jmiller3931/PNI_COIN/PNICoin.xlsx

Designator | MPN | Qty | LINK | Value
C1,C10, C11 | CC0402MRX5R5BB475 | 3 |  | 4.7u
C12 | CL05A106MP8NUB8 | 1 |  | 10u 10V
C14 | CC0402KRX7R9BB103 | 1 |  | 10000p
C2, C3, C4, C6, C13, C15, C16, C17, C18 | CC0402KRX5R6BB104 | 9 |  | 100nF 10V
C5, C9 | CC0402JRNPO9BN101 | 2 |  | 100p
C7, C8, C19 | CC0402KRX5R6BB105 | 3 |  | 1u
J1 | 781710002 | 1 | https://www.digikey.com/product-detail/en/molex/0781710002/WM4459CT-ND/2424928 | CONN_HDR_PICO_EZMATE_2P
J2 | ZX62-AB-5PA(31) | 1 |  | CONN_MICROUSB_HIROSE_XZ024_SMD
LED1, LED2, LED3 | QBLP595-R | 3 | https://www.digikey.com/product-detail/en/qt-brightek-qtb/QBLP595-R/1516-1217-1-ND/6201914 | LEDRED
M1 | SPBTLE-RFTR | 1 |  | MODULE_SPBTLE
R1, R10 | RC0402JR-070RL | 2 |  | 0R
R12 | RC0402FR-07470RL | 1 |  | 470R
R13 | RC0402FR-076K8L | 1 |  | 6.8k
R15 | RC0402FR-0733K2L | 1 |  | 33.2k 1%
R2, R16, R17, R18, R19, R20 | RC0402FR-07121RL | 6 |  | 121R 1%
R3, R4, R5 | RC0402FR-0710KL | 3 |  | 10k
R6, R7 | RC0402FR-074K7L | 2 |  | 4.7k
R8, R9 | RC0402FR-07560RL | 2 |  | 560R
SW1, SW2 | B3U-3000P-B | 2 |  | SW_PB
U1 | STM32L451CEU6 | 1 |  | STM32L451CEU6UFQFPN48
U2 | TPS76433DBVR | 1 |  | TPS76433DBVR
U3 | MCP73832T-2ACI/OT | 1 |  | IC_MCP73832
U4 | Customer Supplied | 1 |  | Note: PNI Will provide U4, MPN: ASM330LHH
U5 | Customer Supplied | 1 | https://www.pnicorp.com/product/rm3100-3 | Note: PNI Will provide U5,SEN1-3: Contact Joe Miller, jmiller@pnicorp.com
SEN-1,SEN2 | Customer Supplied | 2 | https://www.pnicorp.com/product/rm3100-3 | Note: PNI Will provide U5,SEN1-3: Contact Joe Miller, jmiller@pnicorp.com
SEN3 | Customer Supplied | 1 | https://www.pnicorp.com/product/rm3100-3 | Note: PNI Will provide U5,SEN1-3: Contact Joe Miller, jmiller@pnicorp.com
