jmiller3931/PNI_COIN/PNICoin.brd

## EAGLE design PNICoin.brd (2019-02-15)

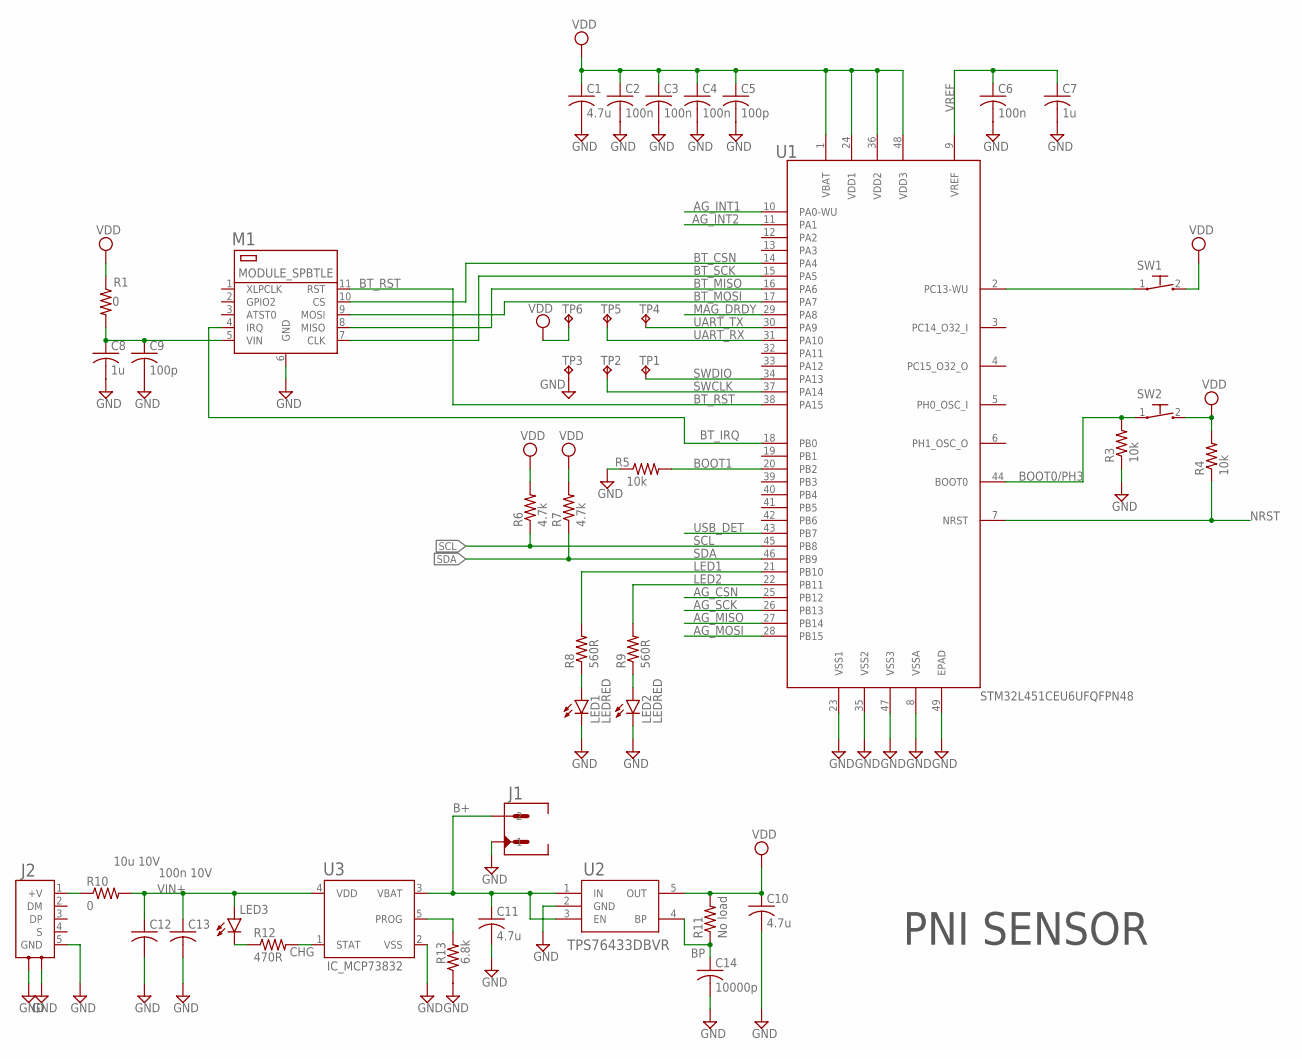
[picture p1: schematic PNICoin.sch, sheet 1]

Parts:
C1, C10, C11: 4.7u; C0402K
C2, C3, C4, C6: 100n; C0402K
C5, C9: 100p; C0402K
C7, C8: 1u; C0402K
C12: 10u 10V; C0402K
C13: 100n 10V; C0402K
C14: 10000p; C0402K
J1: CONN_HDR_PICO_EZMATE_2P; CON_HDR_PICO-EZMATE_2P
J2: CONN_MICROUSB_HIROSE_XZ024_SMD; CON_MICROUSB_HIROSE_XZ024_SMD
LED1, LED2, LED3: LEDRED; LED_0402
M1: MODULE_SPBTLE
R1, R10: 0; R0402
R3, R4, R5: 10k; R0402
R6, R7: 4.7k; R0402
R8, R9: 560R; R0402
R11: No load; R0402
R12: 470R; R0402
R13: 6.8k; R0402
SW1, SW2: SW_PB; SW-PB_B3U-3000PB
TP1, TP2, TP3, TP4, TP5, TP6: TPTP06R; TP06R
U1: STM32L451CEU6UFQFPN48; QFN50P700X700X60-49T560
U2: TPS76433DBVR; DBV5
U3: IC_MCP73832; SOT95P240X125-5

Connections:
AG_CSN: U1.25 (PB12); also elsewhere on the board
AG_INT1: U1.10 (PA0-WU); also elsewhere on the board
AG_INT2: U1.11 (PA1); also elsewhere on the board
AG_MISO: U1.27 (PB14); also elsewhere on the board
AG_MOSI: U1.28 (PB15); also elsewhere on the board
AG_SCK: U1.26 (PB13); also elsewhere on the board
B+: C11.1, J1.2, U2.1 (IN), U2.3 (EN), U3.3 (VBAT)
BLEV+: C8.1, C9.1, M1.5 (VIN), R1.2
BOOT0/PH3: R3.2, SW2.1, U1.44 (BOOT0)
BOOT1: R5.2, U1.20 (PB2)
BP: C14.1, R11.1, U2.4 (BP)
BT_CSN: M1.10 (CS), U1.14 (PA4)
BT_IRQ: M1.4 (IRQ), U1.18 (PB0)
BT_MISO: M1.8 (MISO), U1.16 (PA6)
BT_MOSI: M1.9 (MOSI), U1.17 (PA7)
BT_RST: M1.11 (RST), U1.38 (PA15)
BT_SCK: M1.7 (CLK), U1.15 (PA5)
CHG: R12.2, U3.1 (STAT)
GND: C1.2, C2.2, C3.2, C4.2, C5.2, C6.2, C7.2, C8.2, C9.2, C10.2, C11.2, C12.2, C13.2, C14.2, J1.1, J2.5 (GND), J2.6 (SH1), J2.7 (SH2), LED1.K (C), LED2.K (C), M1.6 (GND), R3.1, R5.1, R13.1, TP3.TP, U1.8 (VSSA), U1.23 (VSS1), U1.35 (VSS2), U1.47 (VSS3), U1.49 (EPAD), U2.2 (GND), U3.2 (VSS); also elsewhere on the board
LED1: R8.2, U1.21 (PB10)
LED1A: LED1.A, R8.1
LED2: R9.2, U1.22 (PB11)
LED2A: LED2.A, R9.1
LED3K: LED3.K (C), R12.1
MAG_DRDY: U1.29 (PA8); also elsewhere on the board
NRST: R4.1, U1.7 (NRST)
PROG: R13.2, U3.5 (PROG)
SCL: R6.1, U1.45 (PB8); also elsewhere on the board
SDA: R7.1, U1.46 (PB9); also elsewhere on the board
SW1: SW1.1, U1.2 (PC13-WU)
SWCLK: TP2.TP, U1.37 (PA14)
SWDIO: TP1.TP, U1.34 (PA13)
UART_RX: TP5.TP, U1.31 (PA10)
UART_TX: TP4.TP, U1.30 (PA9)
USB_DET: U1.43 (PB7)
VDD: C1.1, C2.1, C3.1, C4.1, C5.1, C10.1, R1.1, R4.2, R6.2, R7.2, R11.2, SW1.2, SW2.2, TP6.TP, U1.1 (VBAT), U1.24 (VDD1), U1.36 (VDD2), U1.48 (VDD3), U2.5 (OUT); also elsewhere on the board
VIN: J2.1 (+V), R10.1
VIN+: C12.1, C13.1, LED3.A, R10.2, U3.4 (VDD)
VREF: C6.1, C7.1, U1.9 (VREF)

Notes on the sheet:
PNI SENSOR

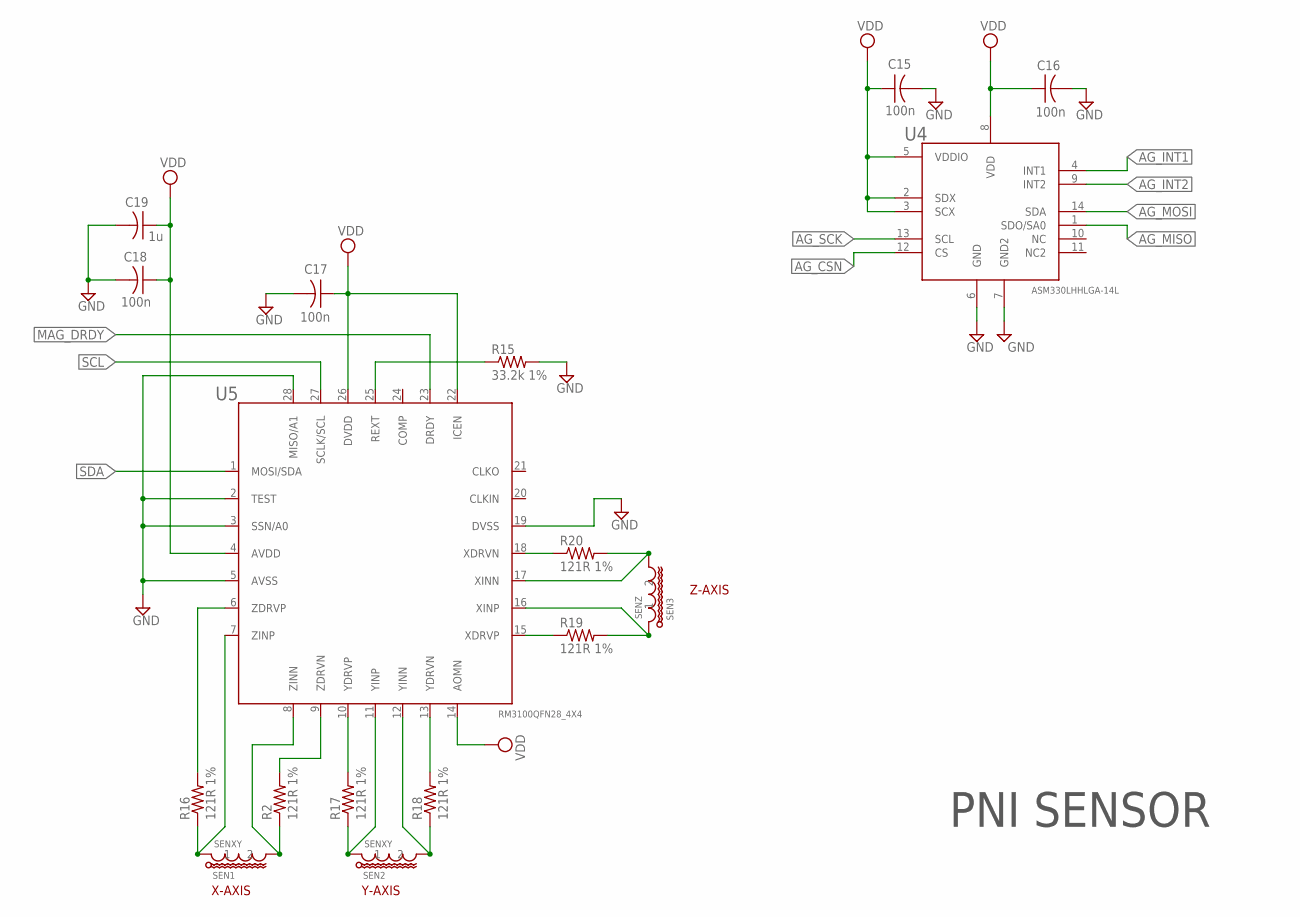
[picture p2: schematic PNICoin.sch, sheet 2]

Parts:
C15, C16, C17, C18: 100n; C0402K
C19: 1u; C0402K
R2, R16, R17, R18, R19, R20: 121R 1%; R0402
R15: 33.2k 1%; R0402
SEN1, SEN2: SENXY
SEN3: SENZ
U4: ASM330LHHLGA-14L; QFN50P300X250X86-14
U5: RM3100QFN28_4X4; QFN40P400X400X80-29T250

Connections:
AG_CSN: U4.12 (CS); also elsewhere on the board
AG_INT1: U4.4 (INT1); also elsewhere on the board
AG_INT2: U4.9 (INT2); also elsewhere on the board
AG_MISO: U4.1 (SDO/SA0); also elsewhere on the board
AG_MOSI: U4.14 (SDA); also elsewhere on the board
AG_SCK: U4.13 (SCL); also elsewhere on the board
GND: C15.2, C16.2, C17.2, C18.2, C19.2, R15.2, U4.6 (GND), U4.7 (GND2), U5.2 (TEST), U5.3 (SSN/A0), U5.5 (AVSS), U5.19 (DVSS), U5.28 (MISO/A1); also elsewhere on the board
MAG_DRDY: U5.23 (DRDY); also elsewhere on the board
REXT: R15.1, U5.25 (REXT)
SCL: U5.27 (SCLK/SCL); also elsewhere on the board
SDA: U5.1 (MOSI/SDA); also elsewhere on the board
VDD: C15.1, C16.1, C17.1, C18.1, C19.1, U4.2 (SDX), U4.3 (SCX), U4.5 (VDDIO), U4.8 (VDD), U5.4 (AVDD), U5.14 (AOMN), U5.22 (ICEN), U5.26 (DVDD); also elsewhere on the board
XDN: R20.1, U5.18 (XDRVN)
XDP: R19.1, U5.15 (XDRVP)
XIN: R20.2, SEN3.2, U5.17 (XINN)
XIP: R19.2, SEN3.1, U5.16 (XINP)
YDN: R18.2, U5.13 (YDRVN)
YDP: R17.2, U5.10 (YDRVP)
YIN: R18.1, SEN2.2, U5.12 (YINN)
YIP: R17.1, SEN2.1, U5.11 (YINP)
ZDN: R2.2, U5.9 (ZDRVN)
ZDP: R16.2, U5.6 (ZDRVP)
ZIN: R2.1, SEN1.2, U5.8 (ZINN)
ZIP: R16.1, SEN1.1, U5.7 (ZINP)

Notes on the sheet:
PNI SENSOR
X-AXIS
Y-AXIS
Z-AXIS

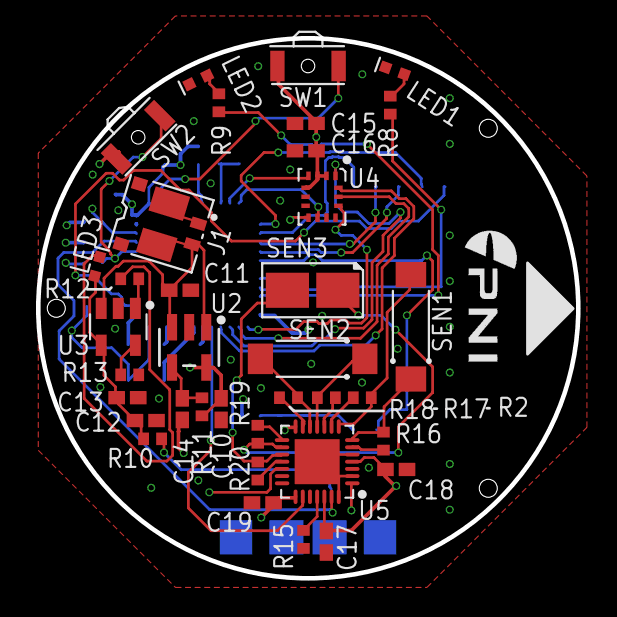
[picture p3: board PNICoin.brd from above]

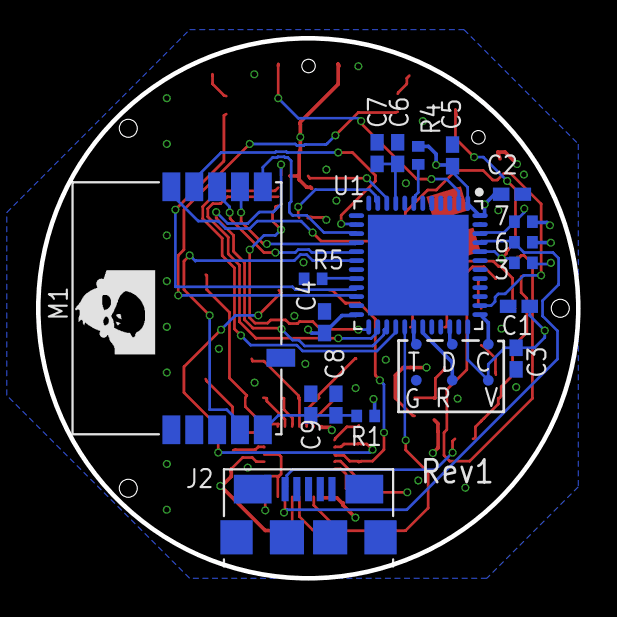
[picture p4: board PNICoin.brd from below]

Board: 4 copper layers, 30.0 x 30.0 mm, 62 parts (24 on the bottom side), 51 nets.

Other parts of the board:
DOC1: DOCFIELD
DOC2: LETTER_L
