jmiller3931/PNI_COIN/PNICoinPanelized.brd

## EAGLE design PNICoinPanelized.brd (2019-02-15)

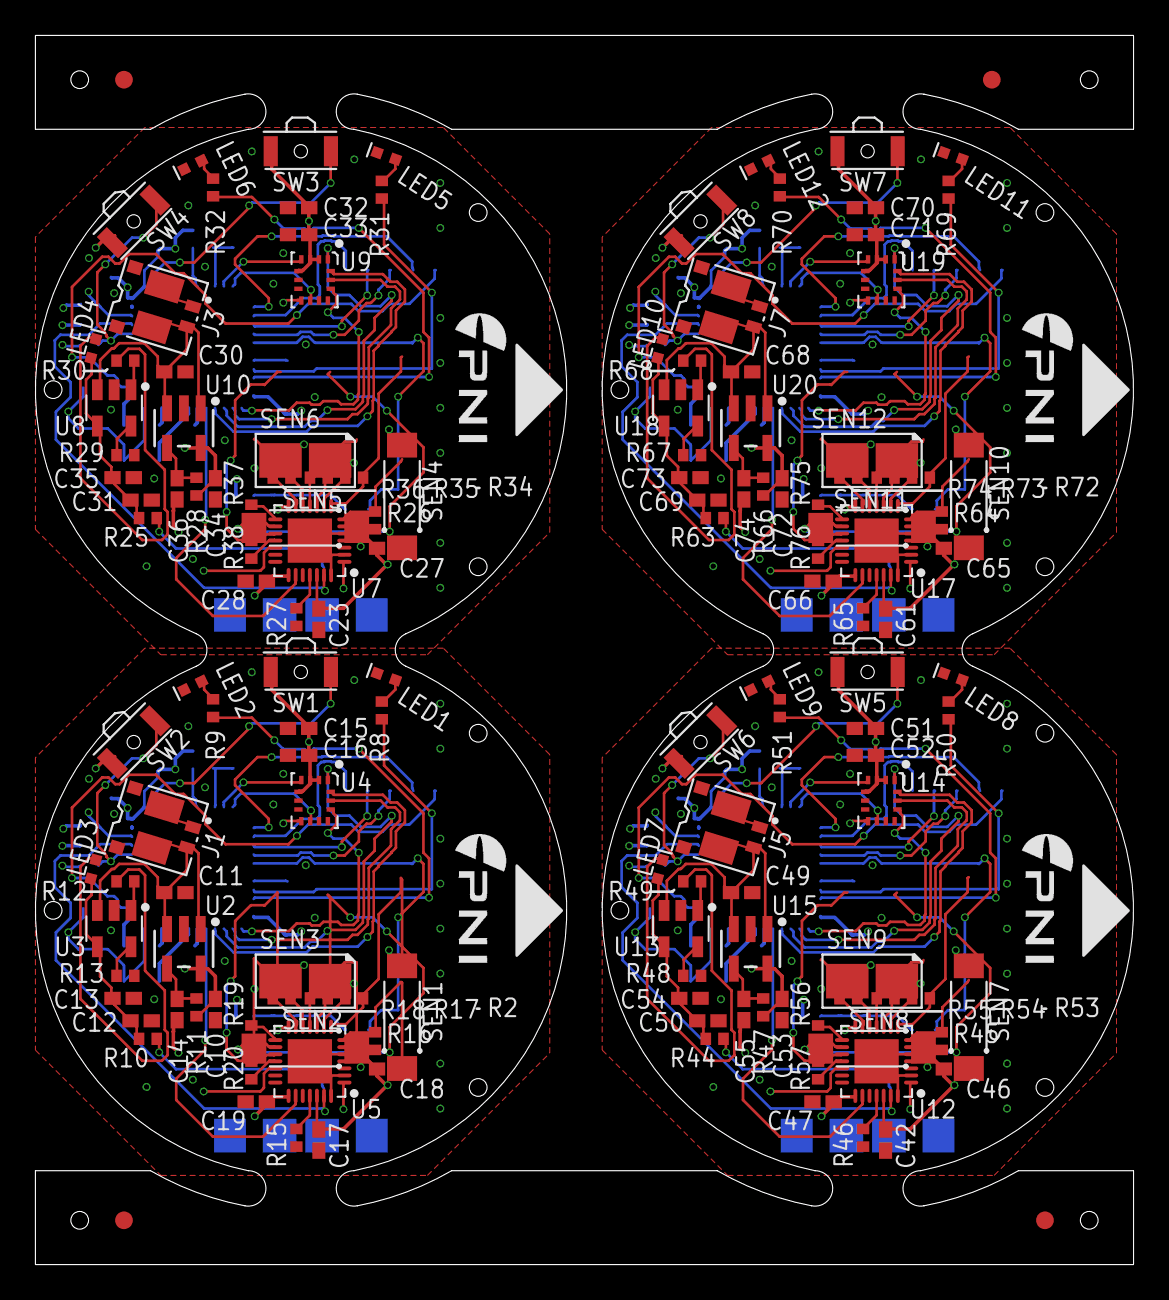
[picture p5: board PNICoinPanelized.brd from above]

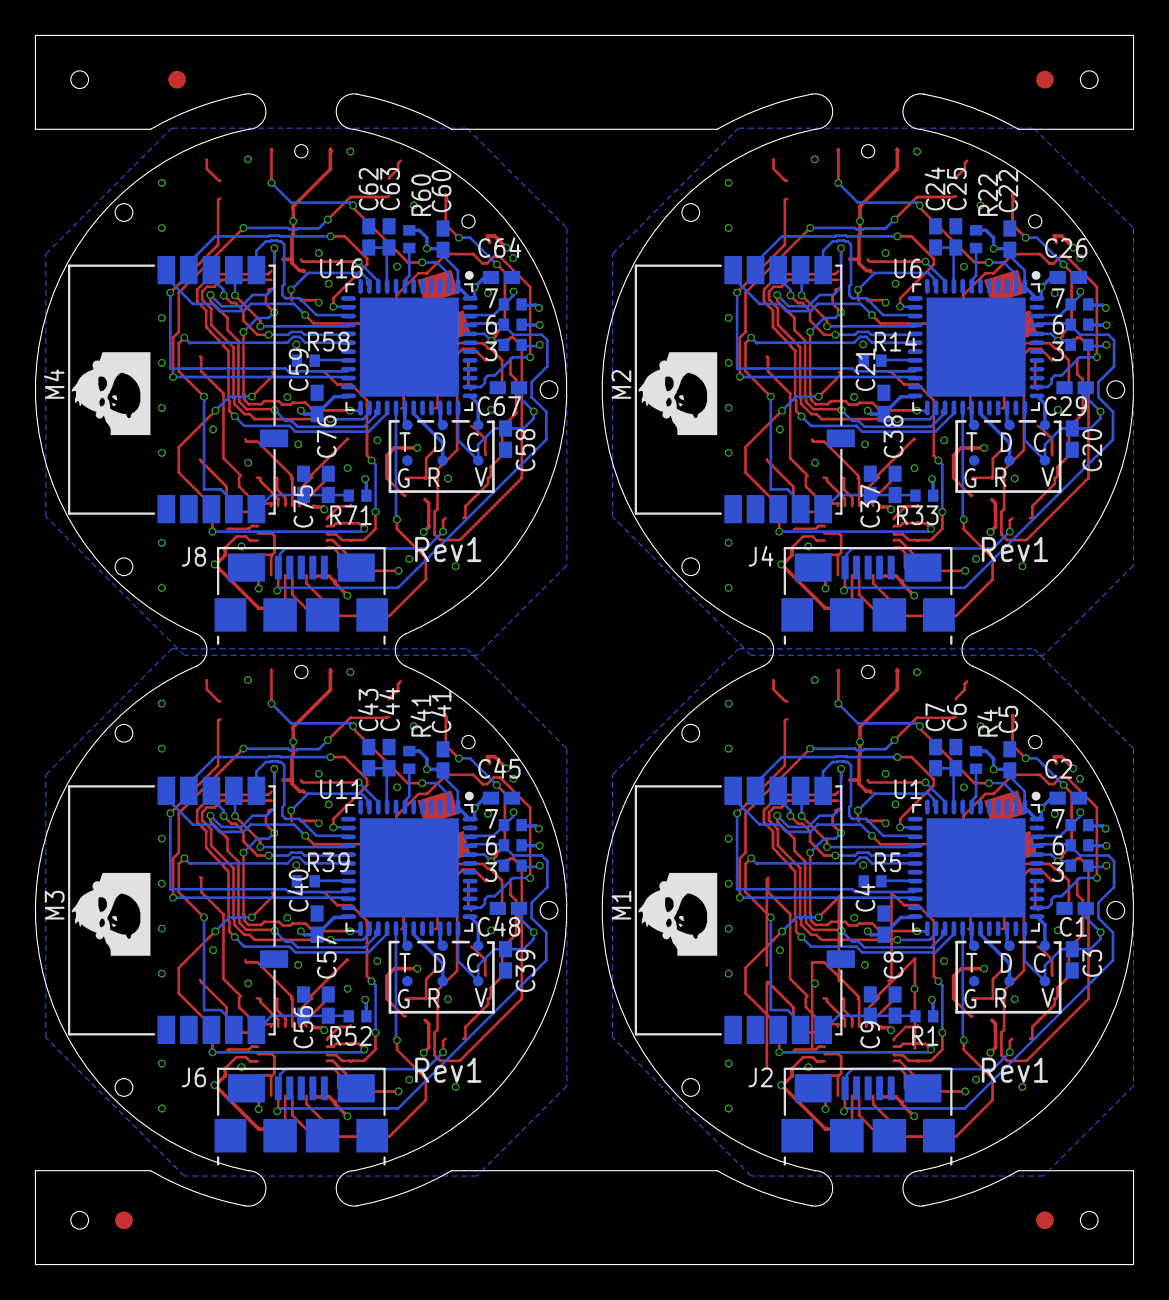
[picture p6: board PNICoinPanelized.brd from below]

Board: 4 copper layers, 62.0 x 69.4 mm, 242 parts (96 on the bottom side), 204 nets.

Parts:
C1, C29, C48, C67: 4.7u; C0402K
C2, C3, C4, C6, C13, C15, C16, C17, C18, C20, C21, C23, C25, C26, C27, C32, C33, C35, C39, C40, C42, C44, C45, C46, C51, C52, C54, C58, C59, C61, C63, C64, C65, C70, C71, C73: 100n; C0402K
C5, C9, C22, C37, C41, C56, C60, C75: 100p; C0402K
C7, C8, C19, C24, C28, C38, C43, C47, C57, C62, C66, C76: 1u; C0402K
C10, C34, C53, C72: 4.7k; C0402K
C11, C30, C49, C68: 4.7U; C0402K
C12, C31, C50, C69: 10u; C0402K
C14, C36, C55, C74: 10000p; C0402K
DOC1: DOCFIELD
DOC2: LETTER_L
J1, J3, J5, J7: CONN_HDR_PICO_EZMATE_2P; CON_HDR_PICO-EZMATE_2P
J2, J4, J6, J8: CONN_MICROUSB_HIROSE_XZ024_SMD; CON_MICROUSB_HIROSE_XZ024_SMD
LED1, LED2, LED3, LED4, LED5, LED6, LED7, LED8, LED9, LED10, LED11, LED12: LED; LED_0402
M1, M2, M3, M4: MODULE_SPBTLE
R1, R10, R25, R33, R44, R52, R63, R71: 0; R0402
R2, R16, R17, R18, R19, R20, R26, R34, R35, R36, R37, R38, R45, R53, R54, R55, R56, R57, R64, R72, R73, R74, R75, R76: 120R 1%; R0402
R3, R4, R5, R14, R21, R22, R39, R40, R41, R58, R59, R60: 10k; R0402
R6, R7, R23, R24, R42, R43, R61, R62: 4.7k; R0402
R8, R9, R31, R32, R50, R51, R69, R70: 560R; R0402
R11, R28, R47, R66: No load; R0402
R12, R30, R49, R68: 470; R0402
R13, R29, R48, R67: 6.8k; R0402
R15, R27, R46, R65: 33.2k 1%; R0402
SEN1, SEN2, SEN4, SEN5, SEN7, SEN8, SEN10, SEN11: SENXY
SEN3, SEN6, SEN9, SEN12: SENZ
SW1, SW2, SW3, SW4, SW5, SW6, SW7, SW8: SW_PB; SW-PB_B3U-3000PB
TP1, TP2, TP3, TP4, TP5, TP6, TP7, TP8, TP9, TP10, TP11, TP12, TP13, TP14, TP15, TP16, TP17, TP18, TP19, TP20, TP21, TP22, TP23, TP24: TPTP06R; TP06R
U1, U6, U11, U16: STM32L451CEU6UFQFPN48; QFN50P700X700X60-49T560
U2, U10, U15, U20: TPS76433DBVR; DBV5
U3, U8, U13, U18: IC_MCP73832; SOT95P240X125-5
U4, U9, U14, U19: ASM330LHHLGA-14L; QFN50P300X250X86-14
U5, U7, U12, U17: RM3100QFN28_4X4; QFN40P400X400X80-29T250

Connections:
AG_CSN: U1.25, U4.12
AG_CSN1: U6.25, U9.12
AG_CSN2: U11.25, U14.12
AG_CSN3: U16.25, U19.12
AG_INT1: U1.10, U4.4
AG_INT2: U1.11, U4.9
AG_INT3: U6.10, U9.4
AG_INT4: U6.11, U9.9
AG_INT5: U11.10, U14.4
AG_INT6: U11.11, U14.9
AG_INT7: U16.10, U19.4
AG_INT8: U16.11, U19.9
AG_MISO: U1.27, U4.1
AG_MISO1: U6.27, U9.1
AG_MISO2: U11.27, U14.1
AG_MISO3: U16.27, U19.1
AG_MOSI: U1.28, U4.14
AG_MOSI1: U6.28, U9.14
AG_MOSI2: U11.28, U14.14
AG_MOSI3: U16.28, U19.14
AG_SCK: U1.26, U4.13
AG_SCK1: U6.26, U9.13
AG_SCK2: U11.26, U14.13
AG_SCK3: U16.26, U19.13
B+: C11.1, J1.2, U2.1, U2.3, U3.3
B+1: C30.1, J3.2, U8.3, U10.1, U10.3
B+2: C49.1, J5.2, U13.3, U15.1, U15.3
B+3: C68.1, J7.2, U18.3, U20.1, U20.3
BLEV+: C8.1, C9.1, M1.5, R1.2
BLEV+1: C37.1, C38.1, M2.5, R33.2
BLEV+2: C56.1, C57.1, M3.5, R52.2
BLEV+3: C75.1, C76.1, M4.5, R71.2
BOOT0/PH1: R21.2, SW4.1, U6.44
BOOT0/PH2: R40.2, SW6.1, U11.44
BOOT0/PH3: R3.2, SW2.1, U1.44
BOOT0/PH4: R59.2, SW8.1, U16.44
BOOT1: R5.2, U1.20
BOOT2: R14.2, U6.20
BOOT3: R39.2, U11.20
BOOT4: R58.2, U16.20
BP: C14.1, R11.1, U2.4
BP1: C36.1, R28.1, U10.4
BP2: C55.1, R47.1, U15.4
BP3: C74.1, R66.1, U20.4
BT_CSN: M1.10, U1.14
BT_CSN1: M2.10, U6.14
BT_CSN2: M3.10, U11.14
BT_CSN3: M4.10, U16.14
BT_IRQ: M1.4, U1.18
BT_IRQ1: M2.4, U6.18
BT_IRQ2: M3.4, U11.18
BT_IRQ3: M4.4, U16.18
BT_MISO: M1.8, U1.16
BT_MISO1: M2.8, U6.16
BT_MISO2: M3.8, U11.16
BT_MISO3: M4.8, U16.16
BT_MOSI: M1.9, U1.17
BT_MOSI1: M2.9, U6.17
BT_MOSI2: M3.9, U11.17
BT_MOSI3: M4.9, U16.17
BT_RST: M1.11, U1.38
BT_RST1: M2.11, U6.38
BT_RST2: M3.11, U11.38
BT_RST3: M4.11, U16.38
BT_SCK: M1.7, U1.15
BT_SCK1: M2.7, U6.15
BT_SCK2: M3.7, U11.15
BT_SCK3: M4.7, U16.15
CHG: R12.2, U3.1
CHG1: R30.2, U8.1
CHG2: R49.2, U13.1
CHG3: R68.2, U18.1
GND: C1.2, C2.2, C3.2, C4.2, C5.2, C6.2, C7.2, C8.2, C9.2, C10.2, C11.2, C12.2, C13.2, C14.2, C15.2, C16.2, C17.2, C18.2, C19.2, J1.1, J2.5, J2.6, J2.7, LED1.K, LED2.K, M1.6, R3.1, R5.1, R13.1, R15.2, TP3.TP, U1.8, U1.23, U1.35, U1.47, U1.49, U2.2, U3.2, U4.6, U4.7, U5.2, U5.3, U5.5, U5.19, U5.28
GND1: C20.2, C21.2, C22.2, C23.2, C24.2, C25.2, C26.2, C27.2, C28.2, C29.2, C30.2, C31.2, C32.2, C33.2, C34.2, C35.2, C36.2, C37.2, C38.2, J3.1, J4.5, J4.6, J4.7, LED5.K, LED6.K, M2.6, R14.1, R21.1, R27.2, R29.1, TP9.TP, U6.8, U6.23, U6.35, U6.47, U6.49, U7.2, U7.3, U7.5, U7.19, U7.28, U8.2, U9.6, U9.7, U10.2
GND2: C39.2, C40.2, C41.2, C42.2, C43.2, C44.2, C45.2, C46.2, C47.2, C48.2, C49.2, C50.2, C51.2, C52.2, C53.2, C54.2, C55.2, C56.2, C57.2, J5.1, J6.5, J6.6, J6.7, LED8.K, LED9.K, M3.6, R39.1, R40.1, R46.2, R48.1, TP15.TP, U11.8, U11.23, U11.35, U11.47, U11.49, U12.2, U12.3, U12.5, U12.19, U12.28, U13.2, U14.6, U14.7, U15.2
GND3: C58.2, C59.2, C60.2, C61.2, C62.2, C63.2, C64.2, C65.2, C66.2, C67.2, C68.2, C69.2, C70.2, C71.2, C72.2, C73.2, C74.2, C75.2, C76.2, J7.1, J8.5, J8.6, J8.7, LED11.K, LED12.K, M4.6, R58.1, R59.1, R65.2, R67.1, TP21.TP, U16.8, U16.23, U16.35, U16.47, U16.49, U17.2, U17.3, U17.5, U17.19, U17.28, U18.2, U19.6, U19.7, U20.2
LED1: R8.2, U1.21
LED1A: LED1.A, R8.1
LED1A1: LED5.A, R31.1
LED1A2: LED8.A, R50.1
LED1A3: LED11.A, R69.1
LED2: R9.2, U1.22
LED2A: LED2.A, R9.1
LED2A1: LED6.A, R32.1
LED2A2: LED9.A, R51.1
LED2A3: LED12.A, R70.1
LED3: R31.2, U6.21
LED3K: LED3.K, R12.1
LED3K1: LED4.K, R30.1
LED3K2: LED7.K, R49.1
LED3K3: LED10.K, R68.1
LED4: R32.2, U6.22
LED5: R50.2, U11.21
LED6: R51.2, U11.22
LED7: R69.2, U16.21
LED8: R70.2, U16.22
MAG_DRDY: U1.29, U5.23
MAG_DRDY1: U6.29, U7.23
MAG_DRDY2: U11.29, U12.23
MAG_DRDY3: U16.29, U17.23
NRST: R4.1, U1.7
NRST1: R22.1, U6.7
NRST2: R41.1, U11.7
NRST3: R60.1, U16.7
PROG: R13.2, U3.5
PROG1: R29.2, U8.5
PROG2: R48.2, U13.5
PROG3: R67.2, U18.5
REXT: R15.1, U5.25
REXT1: R27.1, U7.25
REXT2: R46.1, U12.25
REXT3: R65.1, U17.25
SCL: R6.1, U1.45, U5.27
SCL1: R23.1, U6.45, U7.27
SCL2: R42.1, U11.45, U12.27
SCL3: R61.1, U16.45, U17.27
SDA: R7.1, U1.46, U5.1
SDA1: R24.1, U6.46, U7.1
SDA2: R43.1, U11.46, U12.1
SDA3: R62.1, U16.46, U17.1
SW1: SW1.1, U1.2
SW2: SW3.1, U6.2
SW3: SW5.1, U11.2
SW4: SW7.1, U16.2
SWCLK: TP2.TP, U1.37
SWCLK1: TP8.TP, U6.37
SWCLK2: TP14.TP, U11.37
SWCLK3: TP20.TP, U16.37
SWDIO: TP1.TP, U1.34
SWDIO1: TP7.TP, U6.34
SWDIO2: TP13.TP, U11.34
SWDIO3: TP19.TP, U16.34
UART_RX: TP5.TP, U1.31
UART_RX1: TP11.TP, U6.31
UART_RX2: TP17.TP, U11.31
UART_RX3: TP23.TP, U16.31
UART_TX: TP4.TP, U1.30
UART_TX1: TP10.TP, U6.30
UART_TX2: TP16.TP, U11.30
UART_TX3: TP22.TP, U16.30
VDD: C1.1, C2.1, C3.1, C4.1, C5.1, C10.1, C15.1, C16.1, C17.1, C18.1, C19.1, R1.1, R4.2, R6.2, R7.2, R11.2, SW1.2, SW2.2, TP6.TP, U1.1, U1.24, U1.36, U1.48, U2.5, U4.2, U4.3, U4.5, U4.8, U5.4, U5.14, U5.22, U5.26
VDD1: C20.1, C21.1, C22.1, C23.1, C26.1, C27.1, C28.1, C29.1, C32.1, C33.1, C34.1, R22.2, R23.2, R24.2, R28.2, R33.1, SW3.2, SW4.2, TP12.TP, U6.1, U6.24, U6.36, U6.48, U7.4, U7.14, U7.22, U7.26, U9.2, U9.3, U9.5, U9.8, U10.5
VDD2: C39.1, C40.1, C41.1, C42.1, C45.1, C46.1, C47.1, C48.1, C51.1, C52.1, C53.1, R41.2, R42.2, R43.2, R47.2, R52.1, SW5.2, SW6.2, TP18.TP, U11.1, U11.24, U11.36, U11.48, U12.4, U12.14, U12.22, U12.26, U14.2, U14.3, U14.5, U14.8, U15.5
VDD3: C58.1, C59.1, C60.1, C61.1, C64.1, C65.1, C66.1, C67.1, C70.1, C71.1, C72.1, R60.2, R61.2, R62.2, R66.2, R71.1, SW7.2, SW8.2, TP24.TP, U16.1, U16.24, U16.36, U16.48, U17.4, U17.14, U17.22, U17.26, U19.2, U19.3, U19.5, U19.8, U20.5
VIN: J2.1, R10.1
VIN1: J4.1, R25.1
VIN2: J6.1, R44.1
VIN3: J8.1, R63.1
VIN+: C12.1, C13.1, LED3.A, R10.2, U3.4
VIN+1: C31.1, C35.1, LED4.A, R25.2, U8.4
VIN+2: C50.1, C54.1, LED7.A, R44.2, U13.4
VIN+3: C69.1, C73.1, LED10.A, R63.2, U18.4
VREF: C6.1, C7.1, U1.9
VREF1: C24.1, C25.1, U6.9
VREF2: C43.1, C44.1, U11.9
VREF3: C62.1, C63.1, U16.9
XDN: R20.1, U5.18
XDN1: R38.1, U7.18
XDN2: R57.1, U12.18
XDN3: R76.1, U17.18
XDP: R19.1, U5.15
XDP1: R37.1, U7.15
XDP2: R56.1, U12.15
XDP3: R75.1, U17.15
XIN: R20.2, SEN3.2, U5.17
XIN1: R38.2, SEN6.2, U7.17
XIN2: R57.2, SEN9.2, U12.17
XIN3: R76.2, SEN12.2, U17.17
XIP: R19.2, SEN3.1, U5.16
XIP1: R37.2, SEN6.1, U7.16
XIP2: R56.2, SEN9.1, U12.16
XIP3: R75.2, SEN12.1, U17.16
YDN: R18.2, U5.13
YDN1: R36.2, U7.13
YDN2: R55.2, U12.13
YDN3: R74.2, U17.13
YDP: R17.2, U5.10
YDP1: R35.2, U7.10
YDP2: R54.2, U12.10
YDP3: R73.2, U17.10
YIN: R18.1, SEN2.2, U5.12
YIN1: R36.1, SEN5.2, U7.12
YIN2: R55.1, SEN8.2, U12.12
YIN3: R74.1, SEN11.2, U17.12
YIP: R17.1, SEN2.1, U5.11
YIP1: R35.1, SEN5.1, U7.11
YIP2: R54.1, SEN8.1, U12.11
YIP3: R73.1, SEN11.1, U17.11
ZDN: R2.2, U5.9
ZDN1: R34.2, U7.9
ZDN2: R53.2, U12.9
ZDN3: R72.2, U17.9
ZDP: R16.2, U5.6
ZDP1: R26.2, U7.6
ZDP2: R45.2, U12.6
ZDP3: R64.2, U17.6
ZIN: R2.1, SEN1.2, U5.8
ZIN1: R34.1, SEN4.2, U7.8
ZIN2: R53.1, SEN7.2, U12.8
ZIN3: R72.1, SEN10.2, U17.8
ZIP: R16.1, SEN1.1, U5.7
ZIP1: R26.1, SEN4.1, U7.7
ZIP2: R45.1, SEN7.1, U12.7
ZIP3: R64.1, SEN10.1, U17.7
